7Hunt3r/GoKart-Control/hardware/photos/2026-11-05/08-lesown-guide-pages-2-5.jpg

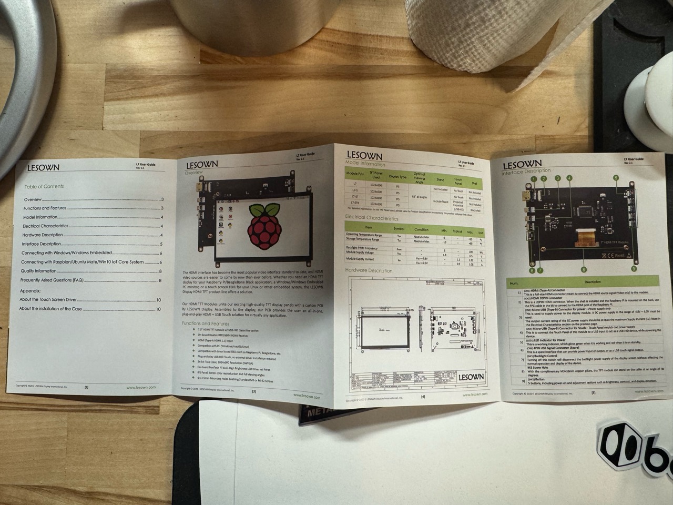
hardware/photos/2026-11-05/08-lesown-guide-pages-2-5.jpg
