7Hunt3r/GoKart-Control/hardware/photos/2026-11-05/07-lesown-guide-pages-6-10.jpg

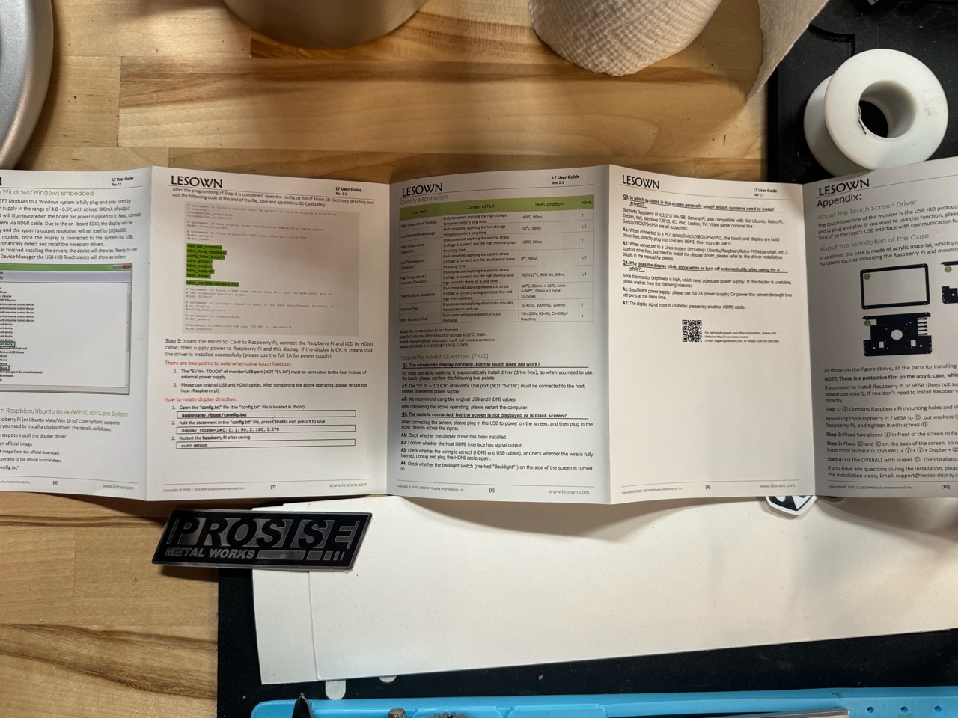
hardware/photos/2026-11-05/07-lesown-guide-pages-6-10.jpg
