7Hunt3r/GoKart-Control/hardware/photos/2026-11-05/01-heltec-front-l76k.jpg

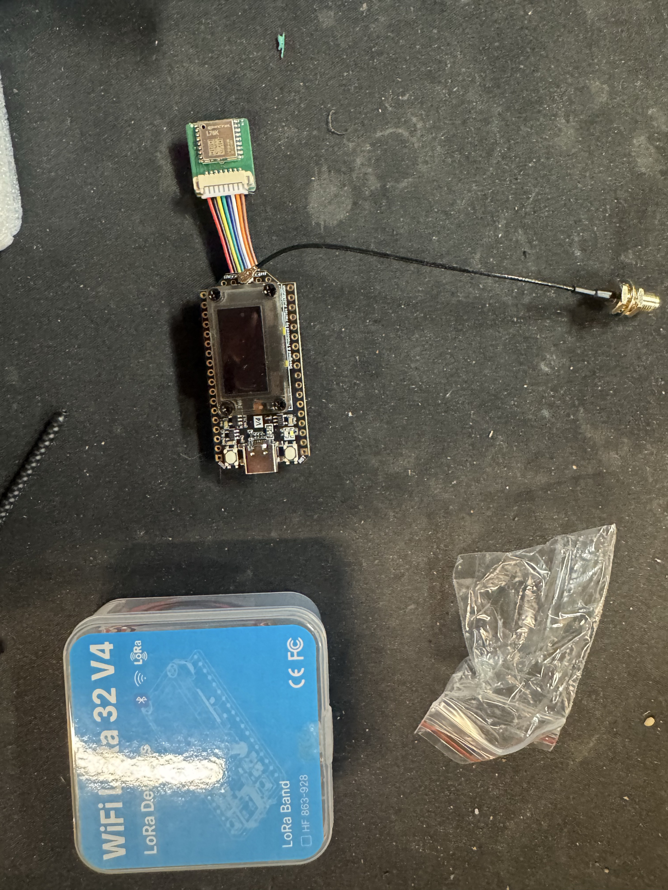
hardware/photos/2026-11-05/01-heltec-front-l76k.jpg
