7Hunt3r/GoKart-Control/hardware/photos/2026-11-05/02-heltec-rear-gps-antenna.jpg

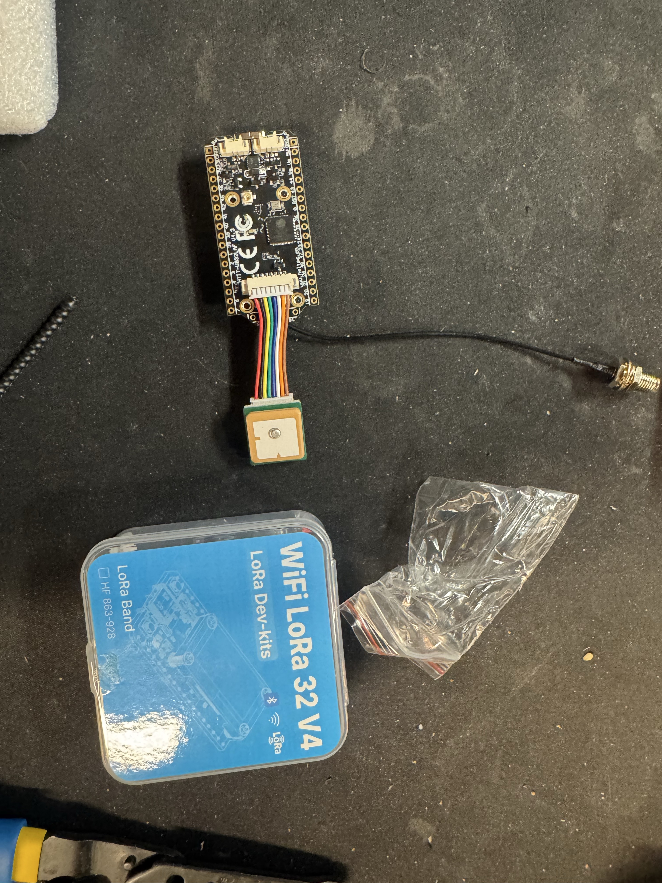
hardware/photos/2026-11-05/02-heltec-rear-gps-antenna.jpg
