7Hunt3r/GoKart-Control/hardware/photos/2026-11-05/03-heltec-packaging.jpg

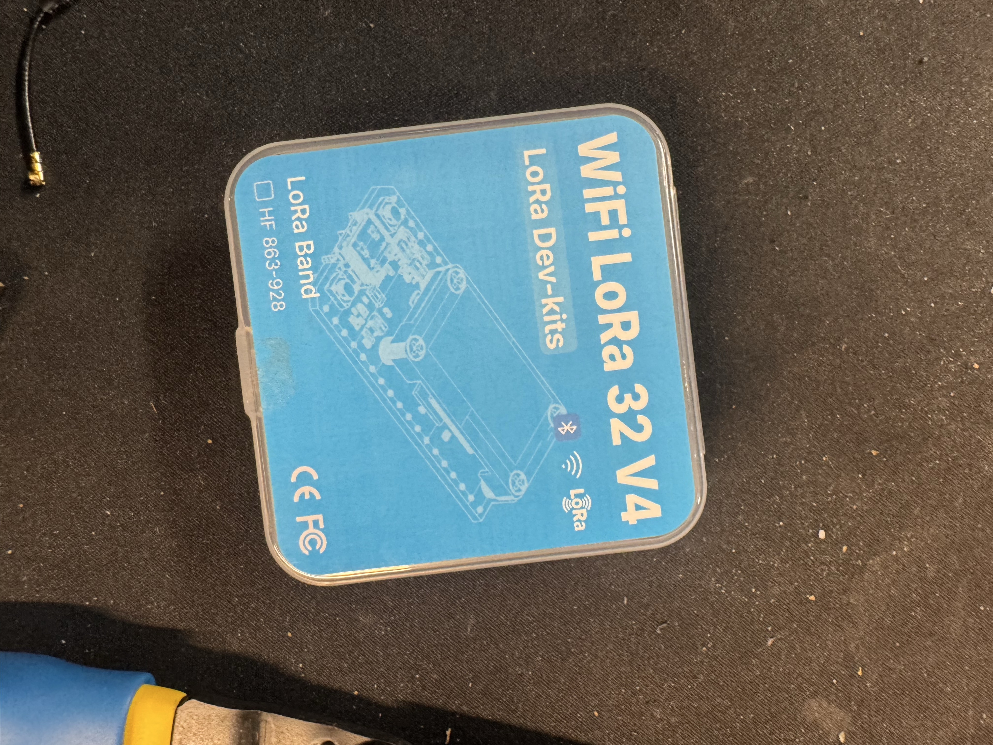
hardware/photos/2026-11-05/03-heltec-packaging.jpg
