7Hunt3r/GoKart-Control/hardware/photos/2026-11-05/04-display-front.jpg

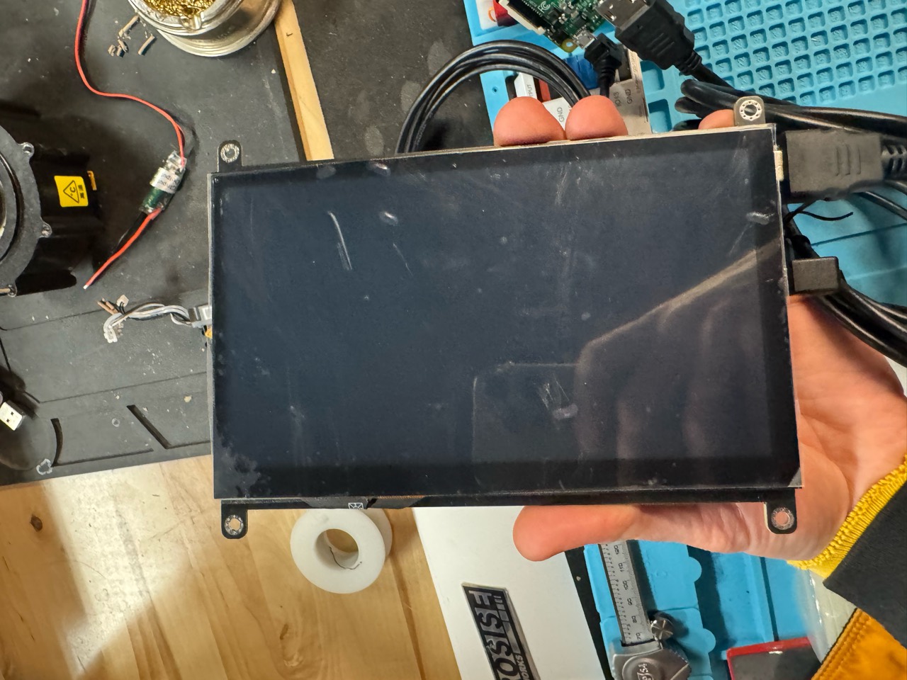
hardware/photos/2026-11-05/04-display-front.jpg
