7Hunt3r/GoKart-Control/hardware/photos/2026-11-05/05-display-connectors-pi3.jpg

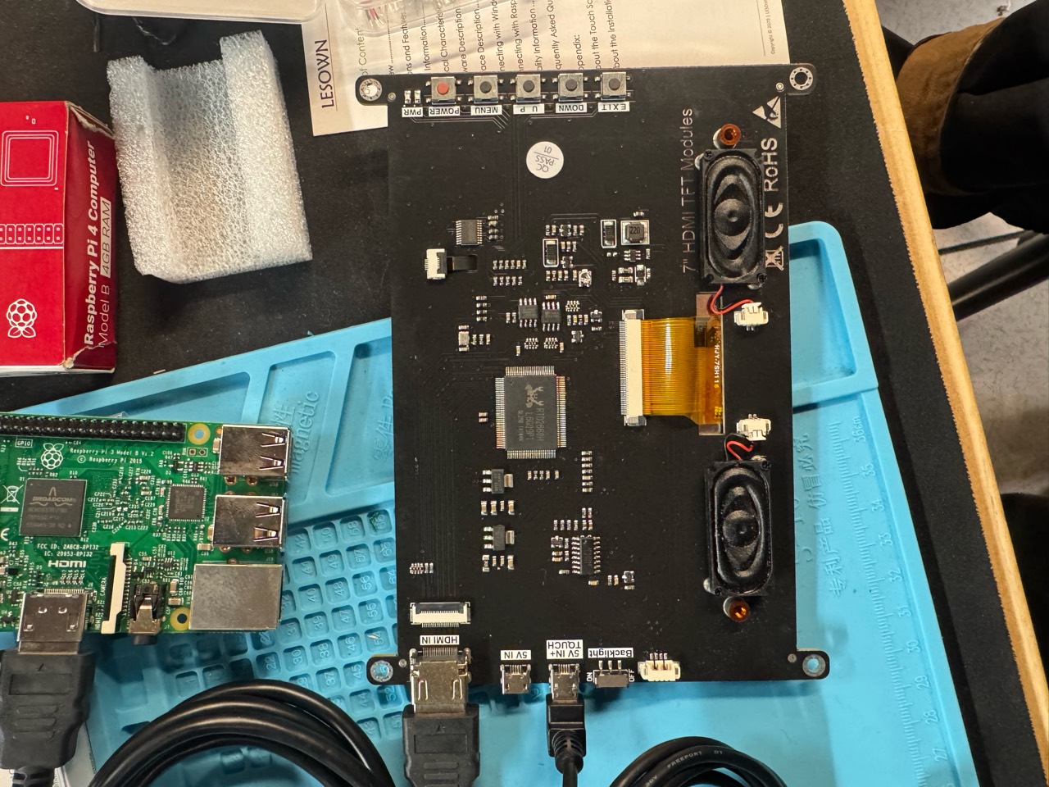
hardware/photos/2026-11-05/05-display-connectors-pi3.jpg
