7Hunt3r/GoKart-Control/pit/server/map/course.jpg

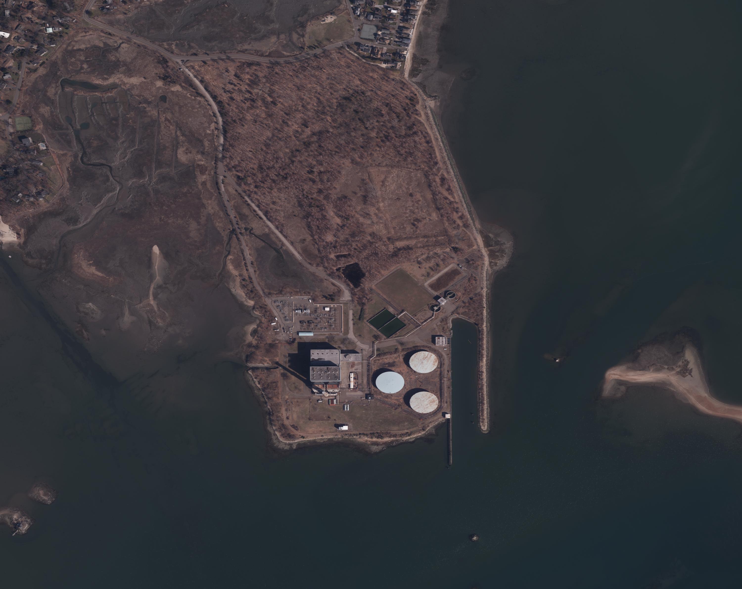
pit/server/map/course.jpg
