7Hunt3r/GoKart-Control/pit/server/map/course_shop_cteco.jpg

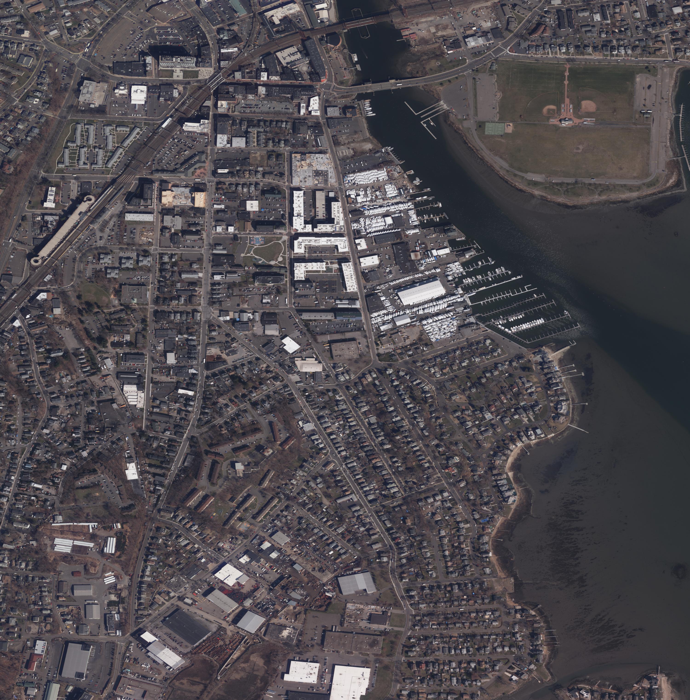
pit/server/map/course_shop_cteco.jpg
