7Hunt3r/GoKart-Control/hardware/photos/2026-11-05/06-lesown-guide-cover.jpg

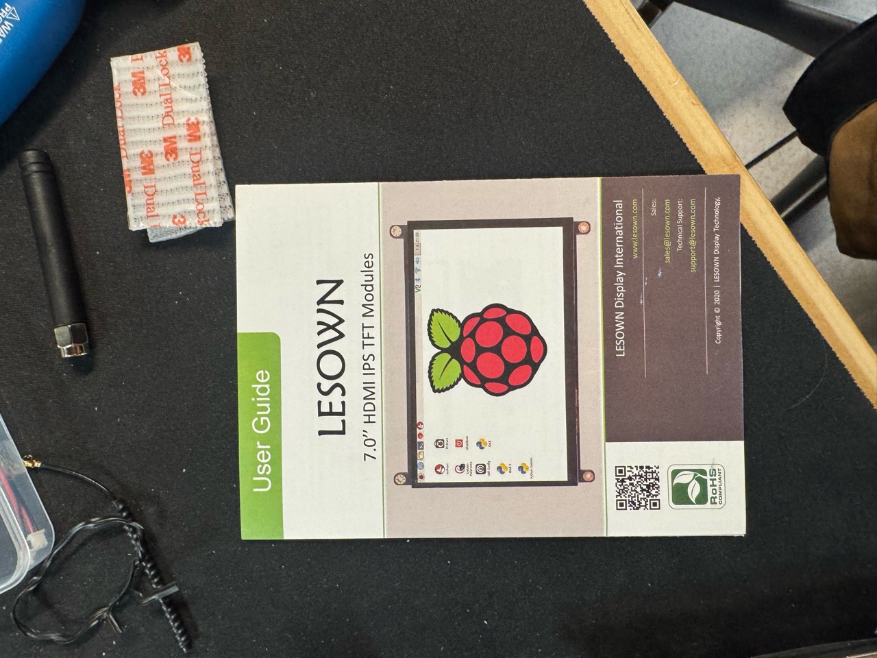
hardware/photos/2026-11-05/06-lesown-guide-cover.jpg
