7Hunt3r/GoKart-Control/firmware/heltec/src/main.cpp

#include <Arduino.h>
#include <NimBLEDevice.h>
#include <RadioLib.h>
#include <TinyGPSPlus.h>
#include <ArduinoJson.h>
#include <WiFi.h>
#include <ArduinoOTA.h>
#include <Preferences.h>
#include <Wire.h>
#include <U8g2lib.h>
#include <GoKartProtocol.h>
#include <atomic>
#include "vesc_protocol.h"
#include "secrets.h"
#include "wifi.local.h"

// Exact HTIT-WB32LAF V4.3 schematic, not the V4.2 GC1109 mapping.
static constexpr int RADIO_CS=8,RADIO_DIO1=14,RADIO_RST=12,RADIO_BUSY=13,RADIO_SCK=9,RADIO_MISO=11,RADIO_MOSI=10;
static constexpr int FEM_POWER=7,FEM_CSD=2,FEM_CTX=5;
static constexpr int OLED_SDA=17,OLED_SCL=18,OLED_RST=21,OLED_VEXT=36;
static constexpr uint8_t EXPECTED_UUID[12]={0x2c,0,0x4c,0,9,0x51,0x34,0x30,0x37,0x35,0x37,0x39};
static const char* SERVICE="6e400001-b5a3-f393-e0a9-e50e24dcca9e";
static const char* NUS_RX="6e400002-b5a3-f393-e0a9-e50e24dcca9e";
static const char* NUS_TX="6e400003-b5a3-f393-e0a9-e50e24dcca9e";
static const char* VERSION="0.2.3-bench";
static constexpr uint32_t STALE_MS=1000;
static constexpr uint32_t LOCAL_TELEMETRY_MS=200; // 5 Hz polling and USB display feed
static constexpr uint32_t OTA_WINDOW_MS=600000;

SPIClass radioSPI(FSPI);
SX1262 radio=new Module(RADIO_CS,RADIO_DIO1,RADIO_RST,RADIO_BUSY,radioSPI);
TinyGPSPlus gps;
Preferences prefs;
U8G2_SSD1306_128X64_NONAME_F_HW_I2C oled(U8G2_R0,OLED_RST,OLED_SCL,OLED_SDA);
bool oledPresent=false;
uint32_t oledRefreshes=0,oledLastMs=0;

struct Chunk {uint16_t len;uint8_t data[256];};
struct Snapshot {vesc::Values values;uint32_t sampled=0;uint32_t samples=0;uint32_t responseMs=0;bool verified=false;};
struct Event {char text[180];};
QueueHandle_t rxQueue,events;
portMUX_TYPE stateMux=portMUX_INITIALIZER_UNLOCKED;
Snapshot current;
std::atomic<bool> maintenance(false),blePaused(false),bleConnected(false),rxOverflow(false);
std::atomic<uint32_t> rxDrops(0);
std::atomic<bool> radioDone(false);
bool radioReady=false,radioActive=false,txEnabled=false,otaActive=false;
uint32_t bootId,sequence=0,lastTx=0,txStarted=0,txCount=0,txErrors=0,otaStarted=0;
int radioInit=-999;
bool otaRebootPending=false;uint32_t otaRebootAt=0;
uint8_t kartId=0; // bench/uncommissioned; do not assign this baseline kart fleet ID 1 implicitly.
String hostName,apName;
char serialOutput[1536];size_t serialLength=0,serialOffset=0;
void emitLine(const String& line){
    if(serialOffset<serialLength || line.length()+1>=sizeof(serialOutput))return;
    memcpy(serialOutput,line.c_str(),line.length());serialOutput[line.length()]='\n';
    serialLength=line.length()+1;serialOffset=0;
}
void pumpOutput(){
    if(serialOffset>=serialLength)return;
    // Let HWCDC service reconnect/backpressure even when its ring buffer is full.
    // availableForWrite()==0 alone can strand queued output after a host closes.
    // A 64-byte write has a 1 ms timeout; never block BLE/radio on a display reader.
    size_t count=min(size_t(64),serialLength-serialOffset);
    serialOffset+=Serial.write((const uint8_t*)serialOutput+serialOffset,count);
}

void event(const char* text){Event e{};snprintf(e.text,sizeof(e.text),"%s",text);xQueueSend(events,&e,0);}
Snapshot snapshot(){portENTER_CRITICAL(&stateMux);Snapshot s=current;portEXIT_CRITICAL(&stateMux);return s;}
void notifyCB(NimBLERemoteCharacteristic*,uint8_t* data,size_t n,bool){
    // Queued to the BLE worker; no parsing or serial/radio waits in BLE callbacks.
    if(n>256){rxOverflow=true;rxDrops++;return;}
    Chunk c{};c.len=n;memcpy(c.data,data,n);
    if(xQueueSend(rxQueue,&c,0)!=pdTRUE){rxOverflow=true;rxDrops++;}
}
void bleWorker(void*){
    NimBLEDevice::init("GoKart Control Bench");
    NimBLEDevice::setPower(3);
    auto scan=NimBLEDevice::getScan();scan->setActiveScan(true);scan->setInterval(100);scan->setWindow(50);
    auto client=NimBLEDevice::createClient();client->setConnectTimeout(4000);
    NimBLERemoteCharacteristic* writer=nullptr;
    vesc::Parser parser;
    bool identified=false,requestPending=false;
    uint32_t lastQuery=0,lastRx=0,lastScan=0,lastRejectReset=0;
    std::vector<std::string> rejected;std::string candidateAddress;
    for(;;){
        if(maintenance){
            if(client->isConnected()) client->disconnect();
            writer=nullptr;identified=false;requestPending=false;bleConnected=false;
            portENTER_CRITICAL(&stateMux);current.verified=false;portEXIT_CRITICAL(&stateMux);
            blePaused=true;vTaskDelay(pdMS_TO_TICKS(20));continue;
        }
        blePaused=false;
        if(!client->isConnected()){
            bleConnected=false;writer=nullptr;identified=false;requestPending=false;parser.reset();
            portENTER_CRITICAL(&stateMux);current.verified=false;portEXIT_CRITICAL(&stateMux);
            xQueueReset(rxQueue);
            if(millis()-lastScan<5000){vTaskDelay(pdMS_TO_TICKS(20));continue;}
            lastScan=millis();event("ble_scan");
            if(millis()-lastRejectReset>60000){rejected.clear();lastRejectReset=millis();}
            auto results=scan->getResults(2000,false);
            for(int i=0;i<results.getCount() && !maintenance;i++){
                auto device=results.getDevice(i);
                if(device->getName()!="VESC BLE UART") continue; // NUS alone is also used by unrelated sensors.
                char line[180];snprintf(line,sizeof(line),"ble_candidate address=%s name=%s rssi=%d",device->getAddress().toString().c_str(),device->getName().c_str(),device->getRSSI());event(line);
                candidateAddress=device->getAddress().toString();
                if(std::find(rejected.begin(),rejected.end(),candidateAddress)!=rejected.end())continue;
                if(!client->connect(device)) continue;
                auto svc=client->getService(SERVICE);
                auto w=svc?svc->getCharacteristic(NUS_RX):nullptr;
                auto n=svc?svc->getCharacteristic(NUS_TX):nullptr;
                if(!w || !n || !(w->canWrite()||w->canWriteNoResponse()) || !n->canNotify() || !n->subscribe(true,notifyCB)){
                    client->disconnect();event("ble_nus_unavailable");continue;
                }
                writer=w;bleConnected=true;lastQuery=0;lastRx=millis();event("ble_connected_identity_pending");break;
            }
            scan->clearResults();
        }
        if(writer && client->isConnected()){
            if(rxOverflow.exchange(false)){parser.reset();xQueueReset(rxQueue);event("ble_rx_overflow_resync");}
            Chunk c;
            while(xQueueReceive(rxQueue,&c,0)==pdTRUE){
                parser.feed(c.data,c.len,[&](const uint8_t* p,size_t n){
                    if(p[0]==0){
                        identified=vesc::matchesIdentity(p,n,EXPECTED_UUID);
                        portENTER_CRITICAL(&stateMux);current.verified=identified;portEXIT_CRITICAL(&stateMux);
                        event(identified?"vesc_identity_verified_fw_6_00":"vesc_identity_rejected");
                        if(!identified){if(rejected.size()<16)rejected.push_back(candidateAddress);client->disconnect();}
                    }
                    vesc::Values v;
                    if(identified && vesc::decode(p,n,v)){
                        portENTER_CRITICAL(&stateMux);
                        current.values=v;current.sampled=millis();current.samples++;current.responseMs=millis()-lastQuery;
                        portEXIT_CRITICAL(&stateMux);
                    }
                    lastRx=millis();requestPending=false;
                });
            }
            if(requestPending && millis()-lastQuery>1200){parser.reset();requestPending=false;event("vesc_response_timeout");}
            if(client->isConnected() && millis()-lastRx>6000){client->disconnect();event("ble_stale_disconnect_read_only");}
            if(client->isConnected() && !requestPending && millis()-lastQuery>=LOCAL_TELEMETRY_MS && !maintenance){
                uint8_t frame[6];vesc::query(identified?4:0,frame);
                lastQuery=millis();requestPending=true;
                // This BLE characteristic write carries only allowlisted GET requests.
                if(!writer->writeValue(frame,sizeof(frame),writer->canWrite())){requestPending=false;client->disconnect();}
            }
        }
        vTaskDelay(pdMS_TO_TICKS(10));
    }
}

void initRadio(){
    pinMode(FEM_POWER,OUTPUT);digitalWrite(FEM_POWER,HIGH);
    pinMode(FEM_CSD,OUTPUT);digitalWrite(FEM_CSD,HIGH);
    pinMode(FEM_CTX,OUTPUT);digitalWrite(FEM_CTX,HIGH);
    radioSPI.begin(RADIO_SCK,RADIO_MISO,RADIO_MOSI,RADIO_CS);
    // Conservative bench setting. SX1262 output is NOT final antenna power (external FEM).
    radioInit=radio.begin(GK_LORA_FREQ_MHZ,GK_LORA_BW_KHZ,GK_LORA_SF,GK_LORA_CR,GK_LORA_SYNC_WORD,0,GK_LORA_PREAMBLE,1.8,false);
    radioReady=radioInit==RADIOLIB_ERR_NONE;
    if(radioReady){radio.setDio2AsRfSwitch(true);radio.setDio1Action([](){radioDone=true;});}
}
void transmit(){
    if(!txEnabled || maintenance || !radioReady || kartId<1 || kartId>GK_MAX_KARTS)return;
    if(radioActive){
        if(radioDone.exchange(false)){radio.finishTransmit();radioActive=false;txCount++;}
        else if(millis()-txStarted>1000){radio.standby();radioActive=false;txErrors++;}
        return;
    }
    static uint32_t interval=GK_REPORT_PERIOD_MS;
    if(millis()-lastTx<interval)return;
    lastTx=millis();interval=GK_REPORT_PERIOD_MS+int32_t(esp_random()%101)-50;
    auto s=snapshot();bool v=s.verified && s.samples && millis()-s.sampled<STALE_MS;
    bool g=gps.location.isValid() && gps.location.age()<3000;
    GkTelemetry packet{};
    gkFillHeader(packet.h,GK_MSG_TELEMETRY,kartId,GK_ADDR_ALL,uint8_t(sequence++));
    packet.mode_req=GK_MODE_UNKNOWN;packet.mode_actual=GK_MODE_UNKNOWN;
    packet.scale_x1000=65535;packet.gps_age_s=gps.location.isValid()?min(uint32_t(254),uint32_t(gps.location.age()/1000)):255;
    packet.uptime_s=uint16_t(millis()/1000);
    // No command reception, mode assertions, stop state, PPS claim or write-enabled flag.
    if(v){
        packet.flags|=GK_FLAG_VESC_LINK;if(s.values.fault)packet.flags|=GK_FLAG_FAULT;
        packet.volts_x10=uint16_t(s.values.voltage*10);
        packet.motor_a_x10=int16_t(constrain(s.values.motorA*10,-32768.f,32767.f));
        packet.batt_a_x10=int16_t(constrain(s.values.batteryA*10,-32768.f,32767.f));
        packet.erpm=s.values.erpm;packet.duty_pct=int8_t(constrain(s.values.duty*100,-100.f,100.f));
        packet.esc_temp_x10=int16_t(s.values.escC*10);packet.fault=s.values.fault;
        packet.ah_x100=uint16_t(constrain(s.values.ampHours*100,0.f,65535.f));
    }
    if(g){
        packet.flags|=GK_FLAG_GPS_FIX;packet.lat_e7=int32_t(gps.location.lat()*1e7);packet.lon_e7=int32_t(gps.location.lng()*1e7);
        if(gps.speed.isValid() && gps.speed.age()<3000)packet.gps_kph_x10=uint16_t(min(65535.0,gps.speed.kmph()*10));
        if(gps.course.isValid() && gps.course.age()<3000)packet.heading_x10=uint16_t(gps.course.deg()*10);
    }
    packet.sats=gps.satellites.isValid() && gps.satellites.age()<3000?min(uint32_t(255),gps.satellites.value()):0;
    radioDone=false;int state=radio.startTransmit((const uint8_t*)&packet,sizeof(packet));
    if(state==RADIOLIB_ERR_NONE){radioActive=true;txStarted=millis();}else txErrors++;
}
bool oledResponds(){Wire.beginTransmission(0x3c);return Wire.endTransmission()==0;}
void initOled(){
    // Same V4.3 power/reset/I2C mapping as Eamon's integrated kart image.
    pinMode(OLED_VEXT,OUTPUT);digitalWrite(OLED_VEXT,LOW);delay(50);
    pinMode(OLED_RST,OUTPUT);digitalWrite(OLED_RST,LOW);delay(10);digitalWrite(OLED_RST,HIGH);delay(10);
    Wire.begin(OLED_SDA,OLED_SCL,400000);Wire.setTimeOut(5);
    oledPresent=oledResponds();
    // U8g2 reconfigures the I2C pins before Wire.begin(). Release the probe bus
    // so the driver actually reattaches those pins instead of reusing a stale bus.
    Wire.end();
    if(!oledPresent){event("oled_not_detected");return;}
    oled.setBusClock(400000);oled.begin();Wire.setTimeOut(5);
    oled.setContrast(160);oled.setPowerSave(0);
    oled.clearBuffer();oled.setFont(u8g2_font_6x10_tf);
    oled.drawStr(0,12,"GoKart Control");oled.drawStr(0,28,VERSION);
    oled.drawStr(0,44,"Starting telemetry...");oled.sendBuffer();oledRefreshes++;
    event("oled_initialized");
}
void serviceOled(){
    if(!oledPresent || radioActive || millis()-oledLastMs<500)return;
    oledLastMs=millis();
    // Stop touching a failed display; BLE and radio do not depend on its presence.
    if(!oledResponds()){oledPresent=false;event("oled_disconnected");return;}
    auto s=snapshot();bool fresh=s.verified && s.samples && millis()-s.sampled<STALE_MS;
    char line[24];oled.clearBuffer();oled.setFont(u8g2_font_6x10_tf);
    snprintf(line,sizeof(line),"Kart %u  TELEMETRY",kartId);oled.drawStr(0,9,line);
    if(fresh)snprintf(line,sizeof(line),"%.1fV %.1fA F%u",s.values.voltage,s.values.motorA,s.values.fault);
    else snprintf(line,sizeof(line),"VESC %s",bleConnected.load()?"waiting / stale":"connecting...");
    oled.drawStr(0,20,line);
    if(fresh)snprintf(line,sizeof(line),"ERPM %ld ESC %.0fC",(long)s.values.erpm,s.values.escC);
    else snprintf(line,sizeof(line),"No fresh motor data");
    oled.drawStr(0,31,line);
    bool fix=gps.location.isValid() && gps.location.age()<3000;
    unsigned sats=gps.satellites.isValid() && gps.satellites.age()<3000?gps.satellites.value():0;
    snprintf(line,sizeof(line),"GPS %s %u sat",fix?"FIX":"NO FIX",sats);oled.drawStr(0,42,line);
    snprintf(line,sizeof(line),"LoRa %s TX %lu",radioReady?(txEnabled?"ON":"OFF"):"ERROR",(unsigned long)txCount);oled.drawStr(0,53,line);
    oled.drawStr(0,64,maintenance.load()?"MAINTENANCE / OTA":"READ ONLY 5Hz / 2Hz");
    oled.sendBuffer();oledRefreshes++;
}
void status(){
    auto s=snapshot();bool fresh=s.verified && s.samples && millis()-s.sampled<STALE_MS;
    JsonDocument d;d["type"]="status";d["firmware"]=VERSION;d["boot_id"]=bootId;d["uptime_ms"]=millis();d["kart_id"]=kartId;
    d["vesc_connected"]=bleConnected.load();d["identity_verified"]=s.verified;d["vesc_fresh"]=fresh;
    d["samples"]=s.samples;d["response_ms"]=s.responseMs;d["rx_drops"]=rxDrops.load();d["sample_age_ms"]=nullptr;
    if(s.samples)d["sample_age_ms"]=millis()-s.sampled;
    if(fresh){d["battery_voltage_v"]=s.values.voltage;d["battery_current_a"]=s.values.batteryA;d["motor_current_a"]=s.values.motorA;d["erpm"]=s.values.erpm;d["duty"]=s.values.duty;d["esc_temperature_c"]=s.values.escC;d["fault_code"]=s.values.fault;d["controller_id"]=s.values.controller;}
    else{for(const char* key:{"battery_voltage_v","battery_current_a","motor_current_a","erpm","duty","esc_temperature_c","fault_code","controller_id"})d[key]=nullptr;}
    d["motor_temperature_c"]=nullptr;d["motor_temperature_reason"]="sensor_not_wired";
    d["gps_chars"]=gps.charsProcessed();d["gps_checksum_pass"]=gps.passedChecksum();d["gps_fix"]=gps.location.isValid() && gps.location.age()<3000;
    if(d["gps_fix"].as<bool>()){d["latitude_deg"]=gps.location.lat();d["longitude_deg"]=gps.location.lng();}else{d["latitude_deg"]=nullptr;d["longitude_deg"]=nullptr;}
    d["satellites"]=gps.satellites.isValid() && gps.satellites.age()<3000?int(gps.satellites.value()):-1;
    d["vesc_poll_interval_ms"]=LOCAL_TELEMETRY_MS;d["usb_report_interval_ms"]=LOCAL_TELEMETRY_MS;d["radio_interval_ms"]=GK_REPORT_PERIOD_MS;
    d["radio_payload_bytes"]=sizeof(GkTelemetry);d["radio_bandwidth_khz"]=GK_LORA_BW_KHZ;d["radio_sequence_next"]=uint8_t(sequence);d["pps_aligned"]=false;d["vesc_writes_enabled"]=false;
    d["radio_init"]=radioInit;d["tx_enabled"]=txEnabled;d["tx_completed"]=txCount;d["tx_errors"]=txErrors;
    d["oled_present"]=oledPresent;d["oled_refreshes"]=oledRefreshes;
    d["maintenance"]=maintenance.load();d["ota_active"]=otaActive;d["free_heap"]=ESP.getFreeHeap();
    if(otaActive){d["ota_hostname"]=hostName;d["ota_ip"]=WiFi.localIP().toString();}
    String line;serializeJson(d,line);emitLine(line);
}
void enterMaintenance(){
    auto s=snapshot();
    if(!s.verified || !s.samples || millis()-s.sampled>STALE_MS || s.values.erpm!=0){event("maintenance_denied_need_fresh_stationary_vesc_or_physical_button");return;}
    maintenance=true;event("maintenance_requested");
}
void stopMaintenance(){ArduinoOTA.end();WiFi.disconnect(true);WiFi.mode(WIFI_OFF);otaActive=false;maintenance=false;event("maintenance_closed");}
void serviceMaintenance(){
    static bool joining=false;
    static uint32_t joinStarted=0;
    if(!maintenance){joining=false;return;}
    if(blePaused && !otaActive && !joining){
        if(radioActive){radio.standby();radioActive=false;} txEnabled=false;
        WiFi.mode(WIFI_STA);WiFi.setHostname(hostName.c_str());WiFi.begin(WIFI_SSID,WIFI_PASSWORD);
        joinStarted=millis();joining=true;event("maintenance_joining_wifi");
    }
    if(joining && WiFi.status()==WL_CONNECTED){
        ArduinoOTA.setHostname(hostName.c_str());ArduinoOTA.setPassword(OTA_PASSWORD);ArduinoOTA.setPort(3232);ArduinoOTA.setRebootOnSuccess(false);
        ArduinoOTA.onStart([](){event("ota_started");});
        ArduinoOTA.onError([](ota_error_t error){char b[64];snprintf(b,sizeof(b),"ota_error=%d",int(error));event(b);});
        ArduinoOTA.onEnd([](){event("ota_complete_rebooting_heltec_only");otaRebootPending=true;otaRebootAt=millis()+1500;});
        ArduinoOTA.begin();otaStarted=millis();otaActive=true;joining=false;event("maintenance_open_10_minutes");
    }
    if(joining && millis()-joinStarted>30000){event("maintenance_wifi_timeout");joining=false;stopMaintenance();}
    if(otaRebootPending && int32_t(millis()-otaRebootAt)>=0)ESP.restart();
    if(otaActive){if(!otaRebootPending)ArduinoOTA.handle();if(millis()-otaStarted>OTA_WINDOW_MS)stopMaintenance();}
}
void command(const String& line){
    if(line=="status")status();
    else if(line=="tx on antenna-confirmed" && !maintenance){txEnabled=radioReady && kartId>=1 && kartId<=GK_MAX_KARTS;event(txEnabled?"tx_enabled":"tx_denied_need_radio_and_kart_id_1_to_8");}
    else if(line=="tx off"){txEnabled=false;event("tx_disabled");}
    else if(line=="maintenance on")enterMaintenance();
    else if(line=="maintenance off")stopMaintenance();
    else if(line=="help")event("status | tx on antenna-confirmed | tx off | maintenance on | maintenance off | id 0..8");
    else if(line.startsWith("id ") && line.length()==4 && line[3]>='0' && line[3]<='8'){
        kartId=line[3]-'0';prefs.putUChar("kart_id",kartId);event("kart_id_saved");
    }else event("command_rejected_no_vesc_write_api");
}
void setup(){
    Serial.begin(115200);Serial.setTxTimeoutMs(1);
    bootId=esp_random();events=xQueueCreate(32,sizeof(Event));rxQueue=xQueueCreate(24,sizeof(Chunk));
    prefs.begin("gkc_bench",false);kartId=prefs.getUChar("kart_id",0);if(kartId>8)kartId=0;
    uint64_t mac=ESP.getEfuseMac();char name[32];snprintf(name,sizeof(name),"gkc-%06lx",(unsigned long)(mac&0xffffff));hostName=name;apName="GoKart-"+hostName;
    pinMode(0,INPUT_PULLUP);
    pinMode(34,OUTPUT);digitalWrite(34,LOW); // GNSS power, active low
    pinMode(42,OUTPUT);digitalWrite(42,HIGH); // GPS reset deasserted
    pinMode(40,OUTPUT);digitalWrite(40,HIGH); // GPS awake
    pinMode(38,INPUT);pinMode(39,INPUT);
    Serial1.begin(9600,SERIAL_8N1,39,-1); // Listen only: GPS TX net is GPIO39; do not drive either UART wire.
    initOled();
    initRadio();
    xTaskCreatePinnedToCore(bleWorker,"vesc-read-only",10000,nullptr,2,nullptr,0);
    event("boot_read_only_tx_off_ota_off");
}
void loop(){
    // Bounded input processing and separate BLE worker: UI/radio waits cannot send motor commands.
    for(int i=0;i<256 && Serial1.available();i++)gps.encode(Serial1.read());
    static char input[96];static size_t used=0;static bool discard=false;
    for(int i=0;i<128 && Serial.available();i++){
        char c=Serial.read();if(c=='\r')continue;
        if(c=='\n'){if(!discard){input[used]=0;command(String(input));}used=0;discard=false;}
        else if(used<sizeof(input)-1) input[used++]=c;else discard=true;
    }
    static uint32_t held=0;static bool buttonHandled=false;
    if(digitalRead(0)==LOW){if(!held)held=millis();if(!buttonHandled && millis()-held>=3000){maintenance=true;buttonHandled=true;event("physical_maintenance_requested_parked_only");}}
    else {held=0;buttonHandled=false;}
    serviceMaintenance();transmit();serviceOled();
    Event e;if(serialOffset>=serialLength && xQueueReceive(events,&e,0)==pdTRUE){JsonDocument d;d["event"]=e.text;d["uptime_ms"]=millis();String line;serializeJson(d,line);emitLine(line);}
    static uint32_t last=0;if(millis()-last>=LOCAL_TELEMETRY_MS){last=millis();status();}
    pumpOutput();delay(2);
}
