7Hunt3r/GoKart-Control/tests/firmware/Arduino.h

#pragma once
#include <cstddef>
#include <cstdint>
#include <cstring>
uint32_t millis();
class Stream {
public:
  virtual ~Stream() = default;
  virtual int available() = 0;
  virtual int read() = 0;
  virtual size_t write(const uint8_t*, size_t) = 0;
};
