7Hunt3r/GoKart-Control/(commit log)

2026-11-05 Add verified kart baseline, inspection tools, and project handoff
    [motor_configuration.json]
2026-11-05 Assign VESC supervision to Heltec and align shared project contracts
2026-11-05 Keep active ESC settings unchanged across accessory and link failures
2026-11-05 Add kart (Heltec V4.3) and pit base (T-Beam S3) LoRa firmware starter
    Kart node: VESC link over wired UART (BLE build available), 5 Hz telemetry,
    read-only GET_MCCONF reconciliation of the live current scale, L76K GPS with
    PPS-aligned LoRa slot, 1 Hz 46-byte telemetry packet, OLED status, USB JSON
    for the kart Pi, WiFi credentials in flash, ArduinoOTA. Mode/stop/start only
    on explicit pit or USB commands; nothing written on boot, reconnect or
    retransmit, per the owner's reliability rule. Default build has VESC writes
    enabled (flagged in HANDOFF for owner review).
    Pit base: T-Beam S3 Core LoRa modem, JSON over USB per SERIAL_PROTOCOL.md,
    PPS-timed command window, "karts online" OLED, Arduino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
2026-11-05 Add tested Heltec BLE telemetry, LoRa transmitter, GPS and authenticated OTA
    [partitions.csv]
2026-11-05 Add Pi 4 pit station: server, touch kiosk UI, simulator, SD-card kit
    pit/server: stdlib+pyserial host for the T-Beam modem (SERIAL_PROTOCOL.md).
    Fleet state with online/stale/offline and nulls instead of fabricated zeros,
    command manager with retries and per-kart outcomes, JSONL logging, SSE state
    stream, password-protected operator UI and a 1024x600 touch kiosk (per-kart
    mode/stop/start, hold-to-fire STOP ALL, race entry + race mode, local-meters
    map with optional georeferenced imagery). pit/sim: eight simulated karts over a
    pty/TCP honoring commands. pit/tests: 26 unit + end-to-end tests (pass on Mac).
    pit/sdcard: cloud-init Raspberry Pi OS kit (gokart-pit, cage+Chromium kiosk,
    /dev/tbeam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
2026-11-05 Kart: per-source command dedupe with issue time; base verified booting on T-Beam S3
    A retransmit is now recognised only when source, seq and issued_utc_s all
    match the last command from that source (pit and USB tracked separately),
    so a restarted host reusing a seq cannot be mistaken for a retransmit once
    the base has GPS time. Contract updated accordingly.
    Base firmware flashed to the real T-Beam S3 Core: PMU rails, SX1262 and GNSS
    all detected, JSON status flowing over USB. README/HANDOFF record what is
    now verified versus not. The udev rule and port finder match the board's
    real USB identity ("USB JTAG/serial debug unit", 303a:1001).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
    [kart-heltec-v4.ino, link.py]
2026-11-05 Radio: match Colin's bench settings (BW500) and decode his 47-byte frame on the base
    GoKartProtocol now uses 915.0 MHz / BW500 / SF7 / CR4/5 / sync 0x12 / preamble 8,
    the settings of the installed Heltec bench transmitter in PR #2, so both frame
    formats share one channel. The T-Beam base recognises the bench 'GK' frame by
    its first byte, decodes it and emits it as a "tele" line with "bench":true
    (stat gains bench_rx/bench_age_s; the OLED shows it). GoKartProtocol frames are
    unchanged apart from the bandwidth. Which frame becomes the fleet protocol
    remains an open integration decision.
    Base reflashed on the T-Beam S3 over a normal USB upload; running and listening.
    No bench frame heard yet i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
2026-11-05 sdcard: flash.sh no longer aborts on unmounted partitions; FLASH_CONFIRM for non-interactive runs
    The pre-erase file listing used grep inside a command substitution; with
    set -e an unmounted partition (no "Mount Point" line) exited the script
    silently before the confirmation. The confirmation now also accepts
    FLASH_CONFIRM=/dev/diskN from the environment and otherwise reads from the
    terminal, so a piped stdin cannot be swallowed by an earlier command.
2026-11-05 sdcard: flash.sh accepts the auto-mounted boot partition
    The post-write loop exited with "could not mount boot partition" on the
    first real run even though macOS had mounted it at /Volumes/bootfs: the
    grep inside the substitution tripped set -e. Tolerate that and fall back
    to /Volumes/bootfs. The card itself was written and verified.
2026-11-05 sdcard: pin the 1024x600 HDMI mode at first boot
    The LESOWN L7 panel returns an all-zero EDID, so KMS offered only standard
    modes and cage ran it at 1024x768. firstboot.sh now appends
    video=HDMI-A-1:1024x600M@60 video=HDMI-A-2:1024x600M@60 to cmdline.txt.
    Applied by hand on the pit Pi 4 first (2026-11-05).
2026-11-05 pit map: Manresa Island 2023 orthoimagery package
    Exported from the CT ECO Ortho_2023_tiled ImageServer (CT 2023 Spring Aerial
    Imagery, 4-band 3-inch, CC0) as a 3000x2382 natural-colour JPEG in WGS84
    covering 41.068-41.0815 N, 73.4185-73.4015 W (about 1.4 km x 1.5 km around
    the island). Bounds are the service's reported export extent. Origin set to
    the island centre. Course line and pit point still to be drawn; alignment
    not yet field-checked.
    Deployed to the pit Pi 4 on 2026-11-05.
2026-11-05 Add isolated bench-control draft and record blocked motor validation
    [motor_configuration.json]
2026-11-05 pit map v2: October 2026 SkyFi satellite image (local-only), CT ECO as fallback
    map.json now points at course_skyfi.jpg, a Vantor image of 2026-10-12 bought
    through SkyFi, georeferenced by affine registration against the CT ECO 2023
    ortho (frame rotated ~10.8 deg, anisotropic pixels) and warped north-up onto
    the ortho's bounds at ~0.34 m/px; checkerboard check shows sub-metre
    alignment. The file is licensed to Eamon and gitignored; course.jpg (CC0)
    remains in git as the public fallback. Pinch/drag/wheel zoom on the map canvas
    was added in the previous deploy. Deployed to the pit Pi 4.
2026-11-05 pit UI: pinch zoom, drag pan, wheel and double-tap zoom on the map canvas
    Pointer-event based: one finger or mouse pans, two fingers pinch-zoom about
    the midpoint, wheel zooms about the cursor, double-tap zooms in. Any gesture
    leaves auto-fit; the Fit button restores it. Scale clamped to 0.02-60 px/m.
    Deployed to the pit Pi 4 kiosk and checked headless against the simulator
    (no console errors, map renders).
2026-11-05 HANDOFF: bench-test plan for Colin (reception first, then command-capable kart firmware)
    Step 1 proves the LoRa link with Colin's existing bench image (id 1, tx on).
    Step 2 is his decision: remote stop/start/mode require the kart-heltec-v4
    BLE build on the kart's Heltec, because the bench image has no command or
    write path. Documents exactly what that build writes and when, the safe
    first test, how to flash it from either Mac, and how to go back. Adds a
    from-scratch arduino-cli build recipe to firmware/README.
2026-11-05 pit map: site presets (Manresa track / 165 Water St bench), shop image local-only
    The bench karts are at the shop, not the island, so a second north-up cut of
    the SkyFi image around 165 Water St is served for today (map.json = shop
    preset, v3). Presets map.manresa.json and map.shop.json; copy one over
    map.json and restart the server to switch. Both SkyFi-derived images stay
    out of git (license).
2026-11-05 Kart: BLE to the VESC on every kart (owner decision), pinned-address-only connection
    The kart now builds the BLE VESC transport by default (kart-uart remains).
    It connects only to the VESC address pinned with "vescmac"; unpinned it runs a
    non-blocking scan, reports every "VESC BLE UART" in range with RSSI over USB
    and on the OLED, and never connects. "blescan" and "vescmac clear" added.
    Bench results recorded in HANDOFF: first over-the-air link (kart 2 -> T-Beam
    -> Pi kiosk, 1 Hz, zero loss, -13 dBm), command loop (ping applied in ~1 s,
    stop/start answered honestly without a VESC), WiFi OTA update verified.
2026-11-05 Save direct BLE motor-test evidence and reconcile command firmware handoff
2026-11-05 Gate temporary VESC writes on identity and fresh preserved limits
2026-11-05 Pit beacon with slot sync, 2 Hz option, VESC UUID pin; kiosk loss/pit-link/dead reckoning
    Firmware: the base sends a 22-byte beacon once a second in the tail of its
    second (phase, sync source, karts online, UTC); its second is GPS PPS, else
    derived from kart slot timing, else free-running. Karts without PPS align
    their slots to the beacon (sync "beacon"), get UTC from it for command
    expiry, and report the pit's RSSI in every packet. "rate 1|2" selects 1 or
    2 reports per second (50 ms slots at 2 Hz). Stop ramp shortened to ~0.5 s.
    VescLink parses the controller UUID; "vescuuid <hex>|now|clear" pins it and
    a mismatch refuses writes. All three targets compile.
    Pit: rolling 1-minute packet loss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
    [base-tbeam-s3.ino, config.h, kart-heltec-v4.ino, pitcore.py]
2026-11-05 Base: send the beacon every second; kart status reports GPS fix quality
    The beacon was keyed on a second index derived from the edge estimate, which
    resets with every kart packet, so only a handful of beacons went out. Now keyed
    on time since the last beacon. Kart "status" adds gps_fix/sats/hdop/age/lat/lon
    for fix-quality checks over USB. Base reflashed on the pit Pi (esptool
    --no-stub; Debian's esptool package lacks the S3 stub).
    [base-tbeam-s3.ino, kart-heltec-v4.ino]
2026-11-05 Kart: 2 Hz reporting by default
    Owner asked for faster updates. With PPS or beacon sync the two rounds use
    50 ms slots; measured 0.5 s intervals at the pit on the bench.
2026-11-05 firmware/releases: prebuilt kart image (BLE, 2 Hz) with flash and console steps
    So the kart build can be flashed with plain esptool and configured over the
    USB console without installing the Arduino toolchain. SHA-256 recorded.
2026-11-05 Base: commands in their own window before the beacon with 30 ms spacing; kart drains back-to-back packets
    After the beacon was added, commands went out immediately behind it and
    karts missed them. Commands now use 815-895 ms of the base's second, the
    beacon 905-985 ms, with 30 ms between any two transmissions. The kart reads
    up to four queued packets per loop and once more after the slow OLED/WiFi
    work. Boot log and status carry the build date/time. Release image refreshed.
    [base-tbeam-s3.ino, kart-heltec-v4.ino]
2026-11-05 Enable Heltec OLED status with reliable I2C initialization
